SaabFAN/PM9160_Mk3_PrescalerBoard/PM9160_Mk3/PM9160_Mk3.kicad_pcb

## KiCad design PM9160_Mk3/PM9160_Mk3.kicad_pcb (2024-02-17)

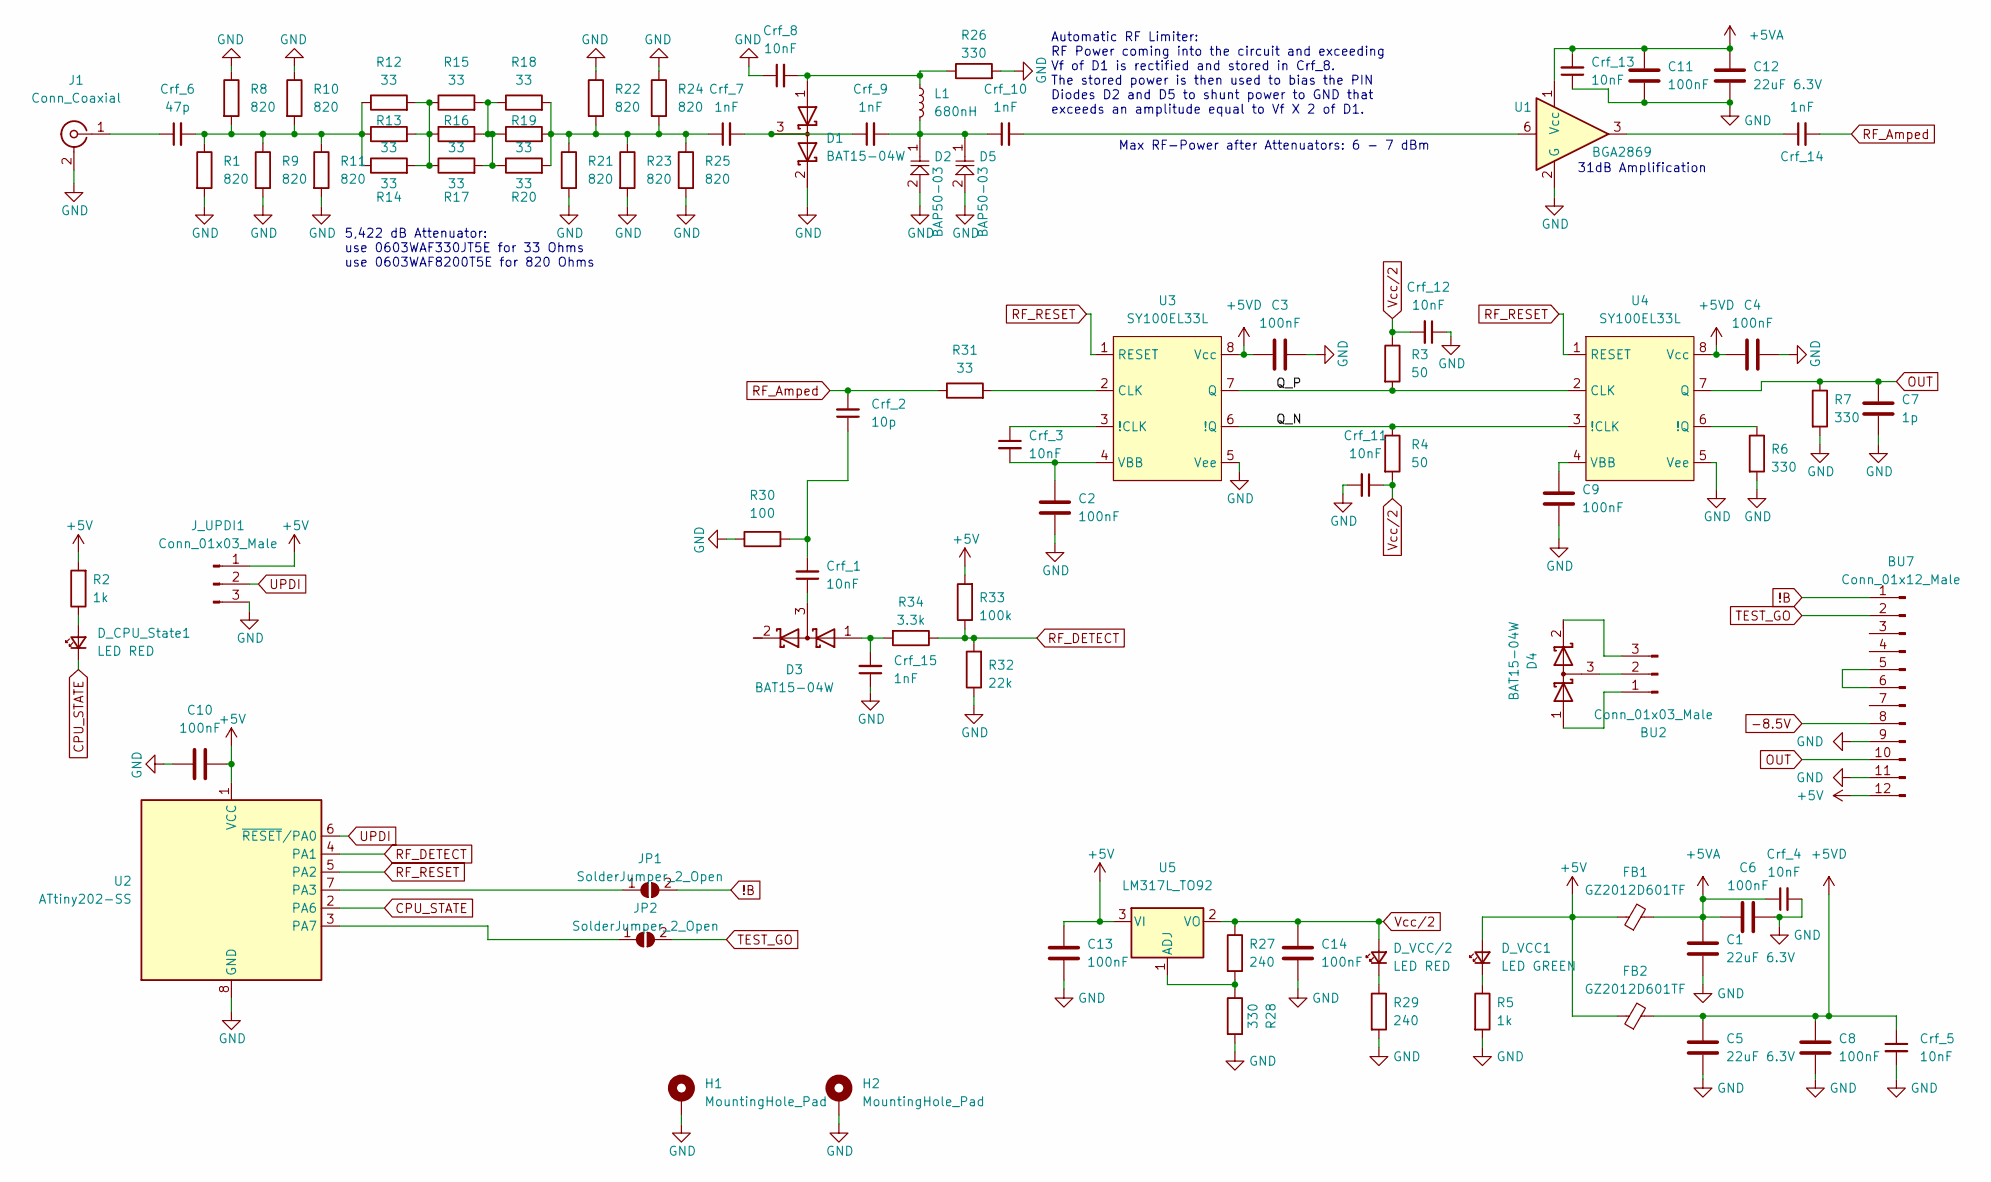
[picture p1: schematic PM9160_Mk3.kicad_sch]

Parts:
BU2: Conn_01x03_Male; PinHeader_1x03_P2.54mm_Vertical
BU7: Conn_01x12_Male; PinHeader_1x12_P2.54mm_Horizontal
C1, C5, C12: 22uF 6.3V; R_0603_1608Metric
C2, C3, C4, C6, C8, C9, C10, C11, C13, C14: 100nF; R_0603_1608Metric
C7: 1p; R_0603_1608Metric
Crf_1, Crf_3, Crf_4, Crf_5, Crf_8, Crf_11, Crf_12, Crf_13: 10nF; R_0402_1005Metric
Crf_2: 10p; R_0402_1005Metric
Crf_6: 47p; R_0402_1005Metric
Crf_7, Crf_9, Crf_10, Crf_14, Crf_15: 1nF; R_0402_1005Metric
D1, D3, D4: BAT15-04W; SOT-323_SC-70
D2, D5: BAP50-03; D_SOD-323_HandSoldering
D_CPU_State1: LED RED; LED_0603_1608Metric
D_VCC1: LED GREEN; LED_0603_1608Metric
D_VCC/2: LED RED; LED_0603_1608Metric
FB1, FB2: GZ2012D601TF; L_0805_2012Metric
H1, H2: MountingHole_Pad; MountingHole_3.2mm_M3_DIN965
J1: Conn_Coaxial; SMA_Molex_73251-1153_EdgeMount_Horizontal
JP1, JP2: SolderJumper_2_Open; SolderJumper-2_P1.3mm_Open_TrianglePad1.0x1.5mm
J_UPDI1: Conn_01x03_Male; PinHeader_1x03_P2.54mm_Vertical
L1: 680nH; L_0603_1608Metric
R1, R8, R9, R10, R11, R21, R22, R23, R24, R25: 820; R_0603_1608Metric
R2, R5: 1k; R_0603_1608Metric
R3, R4: 50; R_0603_1608Metric
R6, R7, R26, R28: 330; R_0603_1608Metric
R12, R13, R14, R15, R16, R17, R18, R19, R20, R31: 33; R_0603_1608Metric
R27, R29: 240; R_0603_1608Metric
R30: 100; R_0603_1608Metric
R32: 22k; R_0603_1608Metric
R33: 100k; R_0603_1608Metric
R34: 3.3k; R_0603_1608Metric
U1: BGA2869; SOT-363_SC-70-6
U2: ATtiny202-SS; SOIC-8_3.9x4.9mm_P1.27mm
U3, U4: SY100EL33L; SOIC-8_3.9x4.9mm_P1.27mm
U5: LM317L_TO92; TO-92_Inline

Connections:
!B: BU7.1, JP1.2 (B)
+5V: BU7.12, C10.2, C13.1, D_VCC1.2 (A), FB1.1, FB2.1, J_UPDI1.1, R2.2, R33.2, U2.1 (VCC), U5.3 (VI)
+5VA: C1.1, C6.1, C11.2, C12.1, Crf_4.1, Crf_13.2, FB1.2, U1.1 (Vcc)
+5VD: C3.1, C4.1, C5.1, C8.1, Crf_5.1, FB2.2, U3.8 (Vcc), U4.8 (Vcc)
-8.5V: BU7.8
/Q_N: R4.1, U3.6 (!Q), U4.3 (!CLK)
/Q_P: R3.2, U3.7 (Q), U4.2 (CLK)
CPU_STATE: D_CPU_State1.1 (K), U2.2 (PA6)
GND: BU7.9, BU7.11, C1.2, C2.2, C3.2, C4.2, C5.2, C6.2, C7.2, C8.2, C9.2, C10.1, C11.1, C12.2, C13.2, C14.2, Crf_4.2, Crf_5.2, Crf_8.1, Crf_11.2, Crf_12.1, Crf_13.1, Crf_15.1, D1.2 (K), D2.2, D5.2, H1.1, H2.1, J1.2 (Ext), J_UPDI1.3, R1.2, R5.2, R6.2, R7.2, R8.1, R9.2, R10.1, R11.2, R21.2, R22.1, R23.2, R24.1, R25.2, R26.2, R28.2, R29.2, R30.1, R32.1, U1.2 (G), U1.4 (G), U1.5 (G), U2.8 (GND), U3.5 (Vee), U4.5 (Vee)
unnamed: BU2.1, D4.1 (A)
unnamed: BU2.2, D4.3 (common)
unnamed: BU2.3, D4.2 (K)
unnamed: BU7.5, BU7.6
unnamed: Crf_1.2, Crf_2.1, R30.2
unnamed: Crf_6.2, R1.1, R8.2, R9.1, R10.2, R11.1, R12.1, R13.1, R14.1
unnamed: Crf_7.1, R18.2, R19.2, R20.2, R21.1, R22.2, R23.1, R24.2, R25.1
unnamed: Crf_9.2, Crf_10.1, D2.1, D5.1, L1.2
unnamed: Crf_10.2, U1.6
unnamed: Crf_14.1, U1.3
unnamed: Crf_8.2, D1.1 (A), L1.1, R26.1
unnamed: Crf_7.2, Crf_9.1, D1.3 (common)
unnamed: Crf_15.2, D3.1 (A), R34.2
unnamed: Crf_1.1, D3.3 (common)
unnamed: D_CPU_State1.2 (A), R2.1
unnamed: D_VCC1.1 (K), R5.1
unnamed: D_VCC/2.1 (K), R29.1
unnamed: Crf_6.1, J1.1 (In)
unnamed: JP1.1 (A), U2.7 (PA3)
unnamed: JP2.1 (A), U2.3 (PA7)
unnamed: R12.2, R13.2, R14.2, R15.1, R16.1, R17.1
unnamed: R15.2, R16.2, R17.2, R18.1, R19.1, R20.1
unnamed: Crf_3.1, U3.3 (!CLK)
unnamed: R31.2, U3.2 (CLK)
unnamed: C2.1, Crf_3.2, U3.4 (VBB)
unnamed: R6.1, U4.6 (!Q)
unnamed: C9.1, U4.4 (VBB)
unnamed: R27.2, R28.1, U5.1 (ADJ)
OUT: BU7.10, C7.1, R7.1, U4.7 (Q)
RF_Amped: Crf_2.2, Crf_14.2, R31.1
RF_DETECT: R32.2, R33.1, R34.1, U2.4 (PA1)
RF_RESET: U2.5 (PA2), U3.1 (RESET), U4.1 (RESET)
TEST_GO: BU7.2, JP2.2 (B)
UPDI: J_UPDI1.2, U2.6 (~RESET/PA0)
Vcc/2: C14.1, Crf_11.1, Crf_12.2, D_VCC/2.2 (A), R3.1, R4.2, R27.1, U5.2 (VO)

Notes on the sheet:
Automatic RF Limiter: RF Power coming into the circuit and exceeding Vf of D1 is rectified and stored in Crf_8. The stored power is then used to bias the PIN Diodes D2 and D5 to shunt power to GND that exceeds an amplitude equal to Vf X 2 of D1.
Max RF-Power after Attenuators: 6 - 7 dBm
5,422 dB Attenuator: use 0603WAF330JT5E for 33 Ohms use 0603WAF8200T5E for 820 Ohms
31dB Amplification

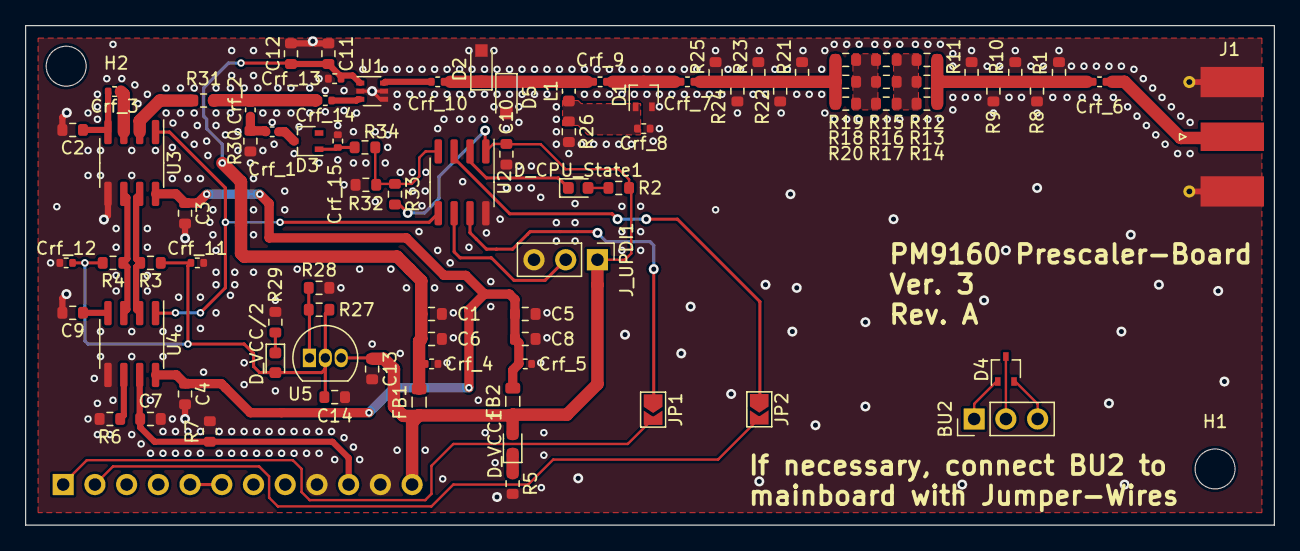
[picture p2: board PM9160_Mk3.kicad_pcb from above]

Board: 2 copper layers, 100.0 x 40.0 mm, 87 parts (1 on the bottom side), 43 nets.
