SaabFAN/PM9160_Mk3_PrescalerBoard/(commit log)

2024-02-17 CPU change and fixed via clearances
    [PM9160_Mk3.kicad_pcb, PM9160_Mk3.kicad_sch]
2024-02-17 Added PlatformIO-Project
    Created a PlatformIO-Project and added it to the repository. Source-Code is not finished.
    [PM9160_Mk3.kicad_sch]
